airbone42/arduino-lego-4wd/README.md

# 🚙 LEGO 4WD car — Arduino UNO R4 WiFi

A four-wheel-drive LEGO car you steer from your phone or a game controller over
your home WiFi. Built with two kids (4 and 8) in small, testable steps — every part
of it is meant to be understood, not just copied.

<p align="center">
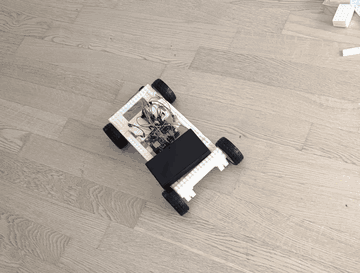
[picture p1: images/video/lego4wd-driving.gif]
The car driving across a wooden floor
  
</p>

<p align="center"><em>
  <a href="images/video/lego4wd-driving.mp4">▶ full video</a>
</em></p>

| | |
|---|---|
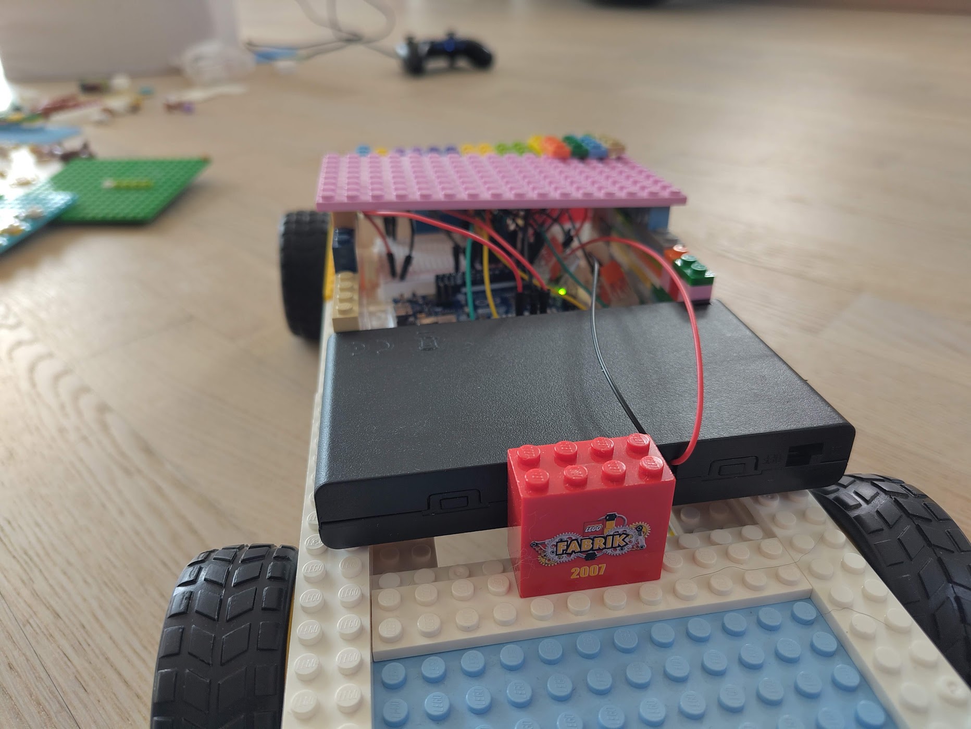
[picture p2: images/photos/car-side-view.jpg]
The finished car from the side
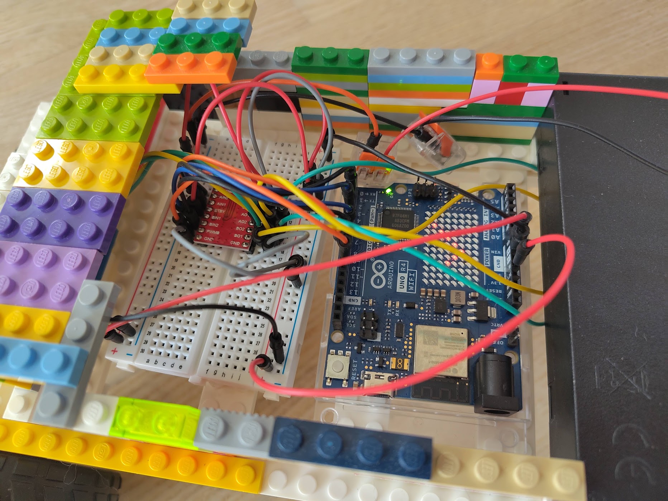
[picture p3: images/photos/electronics-top-view.jpg]
The electronics under the LEGO roof
|  |  |
| The whole thing: LEGO frame, battery pack slung under the deck, electronics on top. | Under the roof — Arduino, breadboard and the TB6612 motor driver. |

## What it does

- **Drives from any phone or tablet.** The Arduino serves a small web page with
  arrow buttons. No app, no pairing, no cloud — just a browser on your home network.
- **Drives from a game controller — with no laptop in the middle.** An ESP32 rides on
  the car, talks Bluetooth to the controller and feeds the Arduino over a single wire.
  There is also a browser page that does the same job from a laptop, if you would
  rather not add a second board.
- **Proportional throttle and steering,** mixed into tank steering, with a 15° wedge
  around straight ahead so a four-year-old can actually drive it in a straight line.
- **Three LEDs on the controller buttons,** switched like light switches.
- **An RGB LED on the right stick** — push up for brighter, down for dimmer, left or
  right to roll through the rainbow. Any colour, while the left stick keeps driving.
- **It makes noise.** A horn on the controller, a starter motor that cranks when the
  controller connects, and a reversing beeper — all played by a tiny M5Stack ATOM
  Echo cube, every wave calculated on the fly. See [docs/sound.md](docs/sound.md).
- **Four-wheel drive, skid steering.** Both left wheels turn together, both right
  wheels turn together. Turn by running one side faster than the other.
- **Updates over WiFi.** After the first USB upload, new firmware goes on the car in
  about 20 seconds while it sits on the floor.
- **Stops on its own.** If commands stop arriving — finger off the button, browser
  closed, WiFi dropped — the motors cut out after 800 ms.
- **Says what it is doing.** The Arduino's built-in 12×8 LED matrix shows the WiFi
  state when it stands still — check mark, cross, or searching dots — and a rotating
  heading arrow while it drives. On battery there is no serial monitor, so this is the
  only debugging you get.

## Build it

| Step | |
|---|--|
| 1 | **[Parts list](docs/parts-list.md)** — roughly €55–70 of electronics, plus LEGO you already own |
| 2 | **[3D printed parts](docs/3d-printed-parts.md)** — four motor brackets, the only printed pieces (buyable too) |
| 3 | **[Soldering](docs/soldering.md)** — pin headers and motor wires; a good first soldering project |
| 4 | **[Wiring](docs/wiring.md)** — the full connection table and why each wire is where it is |
| 5 | **[Build notes](docs/build-notes.md)** — the mistakes we made, so you can skip them |
| — | **[Sound](docs/sound.md)** — horn, starter and reversing beeper on an ATOM Echo (optional) |
| — | **[Troubleshooting](docs/troubleshooting.md)** — when it does not work |
| — | **[Next steps](docs/next-steps.md)** — more sound, speech, a times-tables game, battery monitoring |

### Wiring at a glance

Wiring diagram

The diagram is in stages: **① is the whole car** and is all you need to drive.
The dashed panels below the line — **② lights**, **③ the gamepad bridge** and
**④ the RGB LED** — are optional and can be added later, one at a time. Nothing in
them changes anything in ①. The sound cube is not in the diagram yet; its four wires are in
[docs/sound.md](docs/sound.md).

The Arduino never drives a motor directly — it only sends signals to the TB6612
driver, which switches the battery current through to the motors. Details and the
full pin table are in **[docs/wiring.md](docs/wiring.md)**.

> ⚠️ The battery goes to **VIN**, never to the **5V** pin. The 5V pin sits behind the
> board's regulator; feeding a 9.6 V pack into it destroys the board.

### Flash it

Install [arduino-cli](https://arduino.github.io/arduino-cli/) and the board core once:

```bash
arduino-cli core install arduino:renesas_uno
```

Put in your WiFi credentials:

```bash
cp firmware/lego4wd/arduino_secrets.h.example firmware/lego4wd/arduino_secrets.h
```

Then compile and upload over USB:

```bash
arduino-cli compile --fqbn arduino:renesas_uno:unor4wifi firmware/lego4wd
```

```bash
arduino-cli upload -p COM4 --fqbn arduino:renesas_uno:unor4wifi firmware/lego4wd
```

Watch the serial output to find the car's IP address and MAC:

```bash
arduino-cli monitor -p COM4 -c baudrate=115200
```

Reserve a fixed IP for that MAC in your router. If your router can add local DNS
names, give it one — typing `http://car.lan` beats typing an IP address, especially
for an eight-year-old.

**Before the first drive:** prop the car up so the wheels spin in the air, and start
with the test sketches in [`firmware/tests/`](firmware/tests) — blink, then one
motor, then all four. Each one tells you something different is broken.

## Drive it

<table>
<tr>
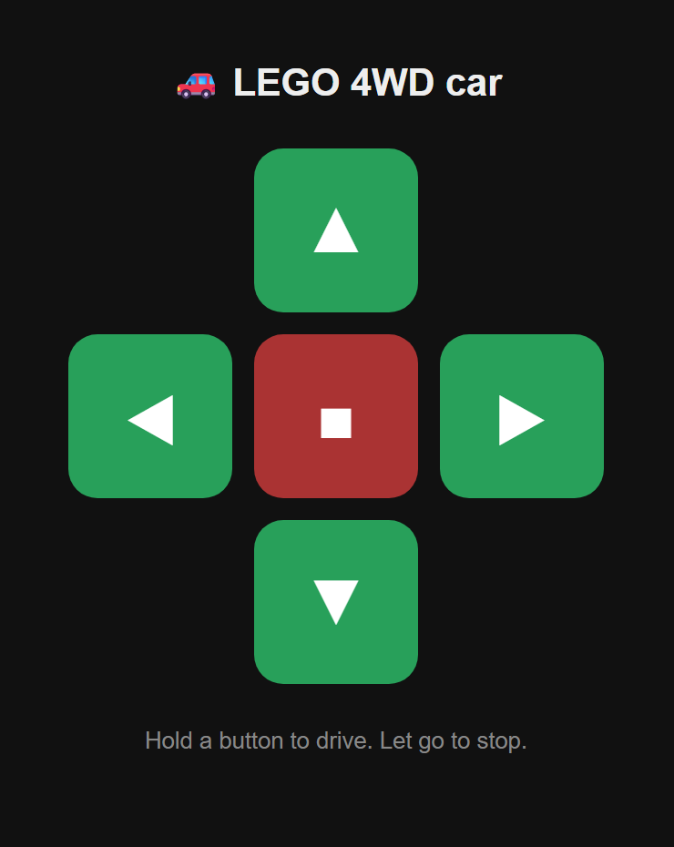
[picture p4: images/screens/phone-page.png]
The phone control page
<td width="42%"></td>
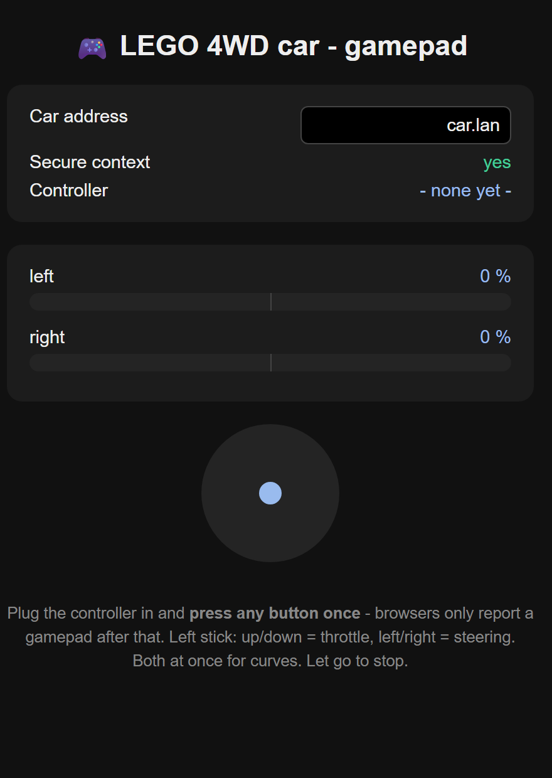
[picture p5: images/screens/gamepad-page.png]
The gamepad control page
<td width="58%"></td>
</tr>
<tr>
<td><b>Phone / tablet</b><br>Open <code>http://&lt;car-address&gt;/</code>. The page is
served by the Arduino itself and lives in the sketch. Hold a button to drive, let go
to stop.</td>
<td><b>Game controller</b><br>Open <a href="controller/gamepad/index.html"><code>controller/gamepad/index.html</code></a>
<b>locally</b> — analog throttle, proportional steering, live readout of both sides.</td>
</tr>
</table>

The gamepad page has to be opened locally (`file://`, or `python -m http.server` and
then `http://localhost:8000`) — **not** served from the Arduino. Browsers only hand
out the Gamepad API in a *secure context*, and plain `http://<ip>/` is not one. The
page tells you whether it got one. Also: press a button on the controller once,
otherwise the browser will not report it at all.

Both pages talk to the same endpoints:

| Request | Meaning |
|---|---|
| `GET /forward` `/back` `/left` `/right` | fixed-speed steps, used by the arrow buttons |
| `GET /drive?l=-100..100&r=-100..100` | proportional, per side, in percent |
| `GET /stop` | stop now |
| `GET /lights?red=1&blue=0&green=1` | switch lights (they also ride along on `/drive`) |
| `GET /lights?bright=100&hue=120` | set the RGB LED — brightness 0–100, hue in degrees (0 red, 120 green, 240 blue) |
| `GET /horn` | a short toot (`/horn?on=0` stops it) — needs the ATOM Echo |
| `GET /status` | what is arriving from the ESP32, decoded — see troubleshooting |
| `GET /selftest` | send a test line out on `D1`, for a `D1`→`D0` loopback check |
| `GET /` | the phone page |

The pages send **percent**, never raw PWM. The speed cap that protects the motors
lives in the sketch and cannot be overridden from outside.

### Or: the controller straight on the car

The browser page needs a laptop following the car around. Putting an **ESP32** on the
car removes it: it pairs with the controller over Bluetooth and passes on what the
controller is doing — raw, both sticks and every button — as one short line over a
single wire, 50 times a second:

```
connected,lx,ly,rx,ry,throttle,brake,buttons,dpad,misc*CS
```

**The ESP32 decides nothing.** Dead zone, the straight-ahead wedge, tank mixing, which
button switches which light, the horn, the RGB LED — all of that lives in the Arduino
sketch (`applyGamepad()`). That was not the first version: the ESP32 used to do the
mixing and send finished speeds, so every new idea meant updating *both* boards — and
over-the-air updates to the ESP32 are the unreliable side (see troubleshooting). Now a
new button is one change to the Arduino sketch over WiFi, and the ESP32 never has to be
touched again.

`*CS` is a checksum, like on a GPS receiver: all characters before the `*` XORed
together, as two hex digits. The line picks up errors while the motors pull hard; a
line whose sum does not match is thrown away, and buttons only count once they arrive
the same twice in a row. The fields are listed in
[docs/troubleshooting.md](docs/troubleshooting.md#is-anything-reaching-the-arduino-at-all).

It is a second source of control, not a replacement: whoever sent the last command
decides where the car goes, and the dead man's switch covers both. A stick at rest
sends one "stop" and then stays quiet, so a controller lying on the sofa does not
fight the phone page. See
[firmware/esp32-gamepad/](firmware/esp32-gamepad/) for the sketch and
[docs/wiring.md](docs/wiring.md) for the two wires and the separate 5 V supply it
needs. Give its ground a wire of its own, straight to the Arduino — sharing the rail
with the motor current mangles the data while you steer.

```powershell
.\tools\ota-esp32.ps1
```

> ⚠️ The ESP32 has a pile of traps that are invisible from the outside — dead pins on
> some module variants, uploads that report success while the old firmware keeps
> running, Bluetooth that does not survive a soft restart. They are all written down
> in [docs/troubleshooting.md](docs/troubleshooting.md). Read that section *before*
> you start debugging, not after.

### Update over WiFi

Once a sketch with the OTA receiver is on the car, the cable can stay in the drawer:

```bash
./tools/ota-upload.sh
```

```powershell
.\tools\ota-upload.ps1 -Address car.lan
```

Both scripts compile, POST the `.bin` to port 65280 with basic auth, and wait for the
car to come back online.

## What is in here

```
firmware/
  lego4wd/            the real firmware: WiFi, web page, OTA, motor control
  esp32-gamepad/      optional: Bluetooth controller bridge on an ESP32
  atom-sound/         optional: horn, starter and reversing beeper on an ATOM Echo
  tests/              build it up in steps: blink → one motor → all four
controller/
  gamepad/            the game controller page (open locally)
tools/
  ota-upload.sh       push new firmware over WiFi (Linux/macOS)
  ota-upload.ps1      the same for Windows
  ota-esp32.sh        the same for the ESP32 bridge (Linux/macOS)
  ota-esp32.ps1       the same for Windows
docs/                 parts, wiring, soldering, build notes, troubleshooting
images/               diagram, photos, screenshots, video
```

## Safety

There are children involved, so:

- Motors always run through the driver and off their own battery — **never** off an
  Arduino pin.
- Check `VCC`/`GND` polarity together, out loud, before switching anything on.
- Every motor test starts with the car **propped up**, wheels in the air.
- Only an adult holds the soldering iron.
- Measure the motor voltage with a multimeter before raising `SPEED_MAX`. The motors
  are rated 3–6 V and the pack delivers ~9.6 V.

## Next steps

Planned, with the pin budget already worked out in
**[docs/next-steps.md](docs/next-steps.md)**:

- **More sound** — an engine note that follows the throttle, one-shot sounds, and a
  bigger speaker, because the one in the cube is honestly too quiet.
- **Speech input**, with an honest look at what a small ESP32 can and cannot do on
  its own. The nice part: anything that can make an HTTP request can already drive
  this car, so the voice path needs no new firmware on the Arduino at all.
- **A times-tables game** — my daughter's idea. The car asks out loud, the question
  appears on the LED matrix, and she drives onto the right answer. The driving *is*
  the answer rather than a reward tacked on afterwards.
- **Battery monitoring**, mostly to make the voltage sag under load visible instead
  of guessable.

## Thanks

To my cousin **Marcel**, who 3D printed the motor brackets for us — the one part of
this build we could not have improvised half as well.

## License

[MIT](LICENSE) — do what you like with it. If you build one, we would love to see it.

LEGO® is a trademark of the LEGO Group, which does not sponsor, authorise or endorse
this project.
