airbone42/arduino-lego-4wd/(commit log)

2026-08-23 LEGO 4WD car: WiFi-controlled Arduino UNO R4 rover
    Full build documentation for a four-wheel-drive LEGO car steered from a phone
    or a game controller over WiFi: firmware, wiring diagram, parts list, soldering
    and assembly notes, troubleshooting, and planned next steps.
2026-09-19 Add the ESP32 gamepad bridge, lights and straight-ahead help
2026-09-19 Rework next steps, and show lights and the ESP32 bridge in the wiring diagram
2026-09-26 Sound: horn, starter and reversing beeper on an ATOM Echo; cleaner ground for the gamepad line
    [atom-sound.ino, esp32-gamepad.ino, lego4wd.ino]
2026-09-27 RGB LED on the right stick; ESP32 now forwards raw controller data with a checksum
